spc6486/bookmac/pcb/keyboard-controller/keyboard-controller-partlist.txt

Partlist exported from Fusion Hub: Scott Chamberlain   Project: Macintosh Protoypes  Board: Keyboard Controller PCB 2D v28 at 9/15/25 21:02

Qty Value                             Device                            Package                 Parts              Description                         AVAILABILITY CATEGORY   CHECK_PRICES                                                                                  COMMENT                         DATASHEET                                      DESCRIPTION                                                                                                                                                                              EU_ROHS_COMPLIANCE                                                                                                                                 MANUFACTURER MF                           MP            MPN            OPERATING_TEMP                                                                         OPERATING_TEMPERATURE PACKAGE                    PACKAGE_SIZE    PACKAGE_TYPE                PART_STATUS PITCH           PRICE ROHS      ROHS_COMPLIANT SERIES SNAPEDA_LINK                                                              SUB-CATEGORY                                                                                   SUBCATEGORY                              TEMPERATURE_COEFFICIENT          THERMALLOSS TOLERANCE TYPE                                                                                       VOLTAGE_RATING
5   .1uF                              C_CHIP-0402(1005-METRIC)          CAPC1005X60             C5, C6, C7, C8, C9 Capacitor - Generic                              Capacitor                                                                                                                                                                                                                                                                                                                                                                                                                                                                                                                                                                                                                                                                                                                                          0402            Surface Mount                                                                                                                                                                                                                                                          Ceramic Capacitors                                                                              MLCC                                                                                                     
1   0466.500NRHF                      0466.500NRHF                      FUSC3115X66N            F1                 Check availability                  In Stock                https://www.snapeda.com/parts/0466.500NRHF/Littelfuse/view-part/?ref=eda                                                                                                                                                           470 Series 1206 Fast-Acting Fuse                                                                                                                                                                                                                                                                   Littelfuse Inc.              0466.500NRHF                                                                                                                              1206 Littelfuse Inc.                                                                               None                                  https://www.snapeda.com/parts/0466.500NRHF/Littelfuse/view-part/?ref=snap                                                                                                                                                                                                                                                                                                         
2   10k                               R_CHIP-0402(1005-METRIC)          RESC1005X40             R1, R3             Resistor Fixed - Generic                         Resistors                                                                                                                                                                               Chip Resistor 1.05 X 0.54 X 0.40 mm body 0402(1005-METRIC) Package                                                                                                                                                                                                                                                                                                                                                                                                                                                                                         0402            Surface Mount                                                                                                                                                                                                                                                                                                                                                                                                                                                                   
1   10uF                              C_CHIP-0402(1005-METRIC)          CAPC1005X60             C1                 Capacitor - Generic                              Capacitor                                                                                                                                                                                                                                                                                                                                                                                                                                                                                                                                                                                                                                                                                                                                          0402            Surface Mount                                                                                                                                                                                                                                                          Ceramic Capacitors                                                                              MLCC                                                                                                     
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
1   5499786-4_2.54-210PWEJECTORHEADER 5499786-4_2.54-210PWEJECTORHEADER TE_5499786-4            J2                 Check availability                  In Stock                https://www.snapeda.com/parts/5499786-4/TE+Connectivity+AMP+Connectors/view-part/?ref=eda     5499786-4                                                                                                                            HEADER                                                                                                                              UNIVERSAL EJECTION PIN                                                                                                                             AMP-LATCH    20 POS                       2.54 X 2.54   PCB            RIGHT ANGLE | TE Connectivity 5499786-4                                               Compliant                                        TE Connectivity 5499786-4                                                     None                                                                                                                                                                                                     None                                                                                            https://www.snapeda.com/parts/5499786-4/TE+Connectivity+AMP+Connectors/view-part/?ref=snap               
1   ATMEGA32U4-AU                     ATMEGA32U4-AU                     QFP80P1200X1200X120-44N U1                 Check availability                  In Stock                https://www.snapeda.com/parts/ATMEGA32U4-AU/Microchip/view-part/?ref=eda                                                                                                                                                           AVR AVR® ATmega Microcontroller IC 8-Bit 16MHz 32KB (16K x 16) FLASH 44-TQFP (10x10)                                                                                                                                                                                                               Microchip Technology / Atmel ATMEGA32U4-AU                                                                                                                             TQFP-44 Microchip                                                                                  None                                  https://www.snapeda.com/parts/ATMEGA32U4-AU/Microchip/view-part/?ref=snap                                                                                                                                                                                                                                                                                                         
1   FL1600087                         FL1600087                         XTAL_FL1600087          Y1                 Check availability                  In Stock                https://www.snapeda.com/parts/FL1600087/Diodes+Inc./view-part/?ref=eda                                                                                                                                                             Crystal 16MHz ±15ppm (Tol) ±15ppm (Stability) 20pF FUND 28.9Ohm 4-Pin SMD                                                                                                                                                                                                                          Diodes Incorporated          FL1600087                                                                                                                                 NON STANDARD-4 Diodes Inc.                                                                         None                                  https://www.snapeda.com/parts/FL1600087/Diodes+Inc./view-part/?ref=snap                                                                                                                                                                                                                                                                                                           
1   PINHD-2X3                         PINHD-2X3                         2X03                    JP1                Pin Header                                       Connectors                                                                                                                                                                              Header-Straight-2x3 Position                                                                                                                                                                                                                                                                                                                                                                                                                                                                                                                                               Through Hole                            0.100" (2.54mm)                                                                                                                                                                                                                Headers                                                                                         Male Pins                                                                                                
1   PRTR5V0U2X,215                    PRTR5V0U2X,215                    SOT143B                 D1                 Check availability                  In Stock                https://www.snapeda.com/parts/PRTR5V0U2X                                                      215/Nexperia/view-part/?ref=eda                                                                                                                                                                                                                                                                                               - Clamp - Ipp Tvs Diode Surface Mount SOT-143B                                                                                         Nexperia USA  PRTR5V0U2X     215                                                                                                                                                     SOT143B-4 Nexperia USA Inc.                                             None                                                                                                                                                                                           https://www.snapeda.com/parts/PRTR5V0U2X 215/Nexperia/view-part/?ref=snap                                                                                                                                
1   SPST-NO_SWITCH_KMR2               SPST-NO_SWITCH_KMR2               KMR2                    S1                 SPST Switches with NO Configuration              Switches                                                                                                                                 https://www.ckswitches.com/media/1479/kmr2.pdf Tactile Switch SPST-NO Top Actuated Surface Mount                                                                                                                                                                                                                                                                                           C&K                                                     KMR211G LFS                                                                                           -40°C ~ 85°C                                     NA              Surface Mount               Active                            Compliant                KMR2                                                                                                                                                                            Tactile Switches                                                                                SPST-NO                                                                                                  
1   TYPE-C-31-M-12                    TYPE-C-31-M-12                    HRO_TYPE-C-31-M-12      J1                 Check availability                  Not in stock            https://www.snapeda.com/parts/TYPE-C-31-M-12/HRO+Electronics+Co.%252C+Ltd./view-part/?ref=eda                                                                                                                                      USB Connectors 24 Receptacle 1 8.94*7.3mm RoHS                                                                                                                                                                                                                                                     HRO Electronics Co.           Ltd.         TYPE-C-31-M-12                                                                                                                                         Package                                                                       None                                                                                                      https://www.snapeda.com/parts/TYPE-C-31-M-12/HRO+Electronics+Co.%252C+Ltd./view-part/?ref=snap
