spc6486/bookmac/pcb/rear-port-av/rear-port-av-partlist.txt

Partlist exported from Fusion Hub: Scott Chamberlain   Project: Macintosh Protoypes  Board: Rear Port AV PCB 2D v21 at 9/16/25 18:32

Qty Value      Device     Package        Parts  Description                   AVAILABILITY CATEGORY   CHECK_PRICES                                                                              DATASHEET                                       DESCRIPTION                                                             MANUFACTURER           MF                                                             MP                                                                   MPN                                                                                    OPERATING_TEMPERATURE PACKAGE                        PACKAGE_SIZE PACKAGE_TYPE PART_STATUS PITCH            PRICE ROHS      SERIES SNAPEDA_LINK SUBCATEGORY             THERMALLOSS                                                        TYPE                                                                 
1   1658998-1  1658998-1  TE_1658998-1   J3     Check availability            In Stock                https://www.snapeda.com/parts/1658998-1/TE+Connectivity+AMP+Connectors/view-part/?ref=eda                                                                                                       Connector          Mini Circular DIN      Receptacle Assy w/ Hold Down                                   8 Pos.                                                               Right Angle | TE Connectivity 1658998-1                                                                     TE Connectivity AMP Connectors 1658998-1                             None                                                 None                                                                                                                                                            
1   B2B-XH-A   B2B-XH-A   B2B-XH-A       J1     XH Connector Top Entry - 2POS              Connectors                                                                                           https://www.jst-mfg.com/product/pdf/eng/eXH.pdf Connector Header Through Hole 2 position 0.098" (2.50mm)                JST Sales America Inc.                                                                                                                                     B2B-XH-A                                                                               -25°C ~ 85°C                                         NA           Through Hole Active      0.098" (2.50mm)        Compliant XH                  Rectangular Connectors                                                                     Male Headers                                                         
1   PINHD-2X4  PINHD-2X4  2X04           JP1    Pin Header                                 Connectors                                                                                                                                           Header-Straight-2x4 Position                                                                                                                                                                                                                                                                                                                                                                Through Hole             0.100" (2.54mm)                                      Headers                                                                                    Male Pins                                                            
1   RCJ-011    RCJ-011    CUI_RCJ-011    J7     Check availability            In Stock                https://www.snapeda.com/parts/RCJ-011/Same+Sky/view-part/?ref=eda                                                                                                                               Metal Right-Angle  RCA Jack               Black Insulator                                                                                                                    Same Sky                                                                               RCJ-011                                                           None                                                      None                                        https://www.snapeda.com/parts/RCJ-011/Same+Sky/view-part/?ref=snap                                                                      
2   SJ1-3533NS SJ1-3533NS CUI_SJ1-3533NS J4, J6 Check availability            In Stock                https://www.snapeda.com/parts/SJ1-3533NS/Same+Sky/view-part/?ref=eda                                                                                                                            3.50mm (0.141      1/8                    Mini Plug) - Headphone Phone Jack Stereo (3 Conductor          TRS) Connector Solder                                                                                                                                      Same Sky              SJ1-3533NS                                               None                                                None                                                                                                    https://www.snapeda.com/parts/SJ1-3533NS/Same+Sky/view-part/?ref=snap
