spc6486/bookmac/pcb/rear-port-power/rear-port-power-partlist.txt

Partlist exported from Fusion Hub: Scott Chamberlain   Project: Macintosh Protoypes  Board: Rear Port Pwr PCB 2D v36 at 9/16/25 21:17

Qty Value        Device       Package         Parts        Description                   AVAILABILITY CATEGORY   CHECK_PRICES                                                           DATASHEET                                       DESCRIPTION                                                                                                                                                                                               MANUFACTURER           MF       MP                    MPN      OPERATING_TEMPERATURE PACKAGE                                                                   PACKAGE_SIZE PACKAGE_TYPE PART_STATUS  PITCH            PRICE ROHS      SERIES SNAPEDA_LINK                                                      SUBCATEGORY             THERMALLOSS TYPE        
2   B2B-XH-A     B2B-XH-A     B2B-XH-A        POWER, RESET XH Connector Top Entry - 2POS              Connectors                                                                        https://www.jst-mfg.com/product/pdf/eng/eXH.pdf Connector Header Through Hole 2 position 0.098" (2.50mm)                                                                                                                                                  JST Sales America Inc.                                B2B-XH-A -25°C ~ 85°C                                                                                    NA           Through Hole Active       0.098" (2.50mm)        Compliant XH                                                                       Rectangular Connectors              Male Headers
1   SPPJ222200   SPPJ222200   SW_SPPJ222200   S1           Check availability            In Stock                https://www.snapeda.com/parts/SPPJ222200/ALPS/view-part/?ref=eda                                                                                                             Switch Push Button N.O./N.C. DPDT Plunger 0.2A 30VDC Latching PC Pins Bracket Mount/Through Hole Bulk                                                                      ALPS     SPPJ222200                                           None                                                                                                                              None                   https://www.snapeda.com/parts/SPPJ222200/ALPS/view-part/?ref=snap                                                 
1   TL1105RF160Q TL1105RF160Q SW_TL1105RF160Q S2           Check availability            In Stock                https://www.snapeda.com/parts/TL1105RF160Q/E-Switch/view-part/?ref=eda                                                                                                       Tactile Switch                                                                                                                                       TL1105 Series          SPST-NO  6.15mm Side Actuated  0.05A    12VDC                 PC | E-Switch TL1105RF160Q                                                            E-Switch     TL1105RF160Q                        None                                                                                                                   None
