spc6486/bookmac/pcb/keyboard/keyboard-bom.xlsx

Comment | Designator | Footprint | JLCPCB Part #（optional）
Diode | D1 | 1N4148W-7-F
Diode | D2 | 1N4148W-7-F
Diode | D3 | 1N4148W-7-F
Diode | D4 | 1N4148W-7-F
Diode | D5 | 1N4148W-7-F
Diode | D6 | 1N4148W-7-F
Diode | D7 | 1N4148W-7-F
Diode | D8 | 1N4148W-7-F
Diode | D9 | 1N4148W-7-F
Diode | D10 | 1N4148W-7-F
Diode | D11 | 1N4148W-7-F
Diode | D12 | 1N4148W-7-F
Diode | D13 | 1N4148W-7-F
Diode | D14 | 1N4148W-7-F
Diode | D15 | 1N4148W-7-F
Diode | D16 | 1N4148W-7-F
Diode | D17 | 1N4148W-7-F
Diode | D18 | 1N4148W-7-F
Diode | D19 | 1N4148W-7-F
Diode | D20 | 1N4148W-7-F
Diode | D21 | 1N4148W-7-F
Diode | D22 | 1N4148W-7-F
Diode | D23 | 1N4148W-7-F
Diode | D24 | 1N4148W-7-F
Diode | D25 | 1N4148W-7-F
Diode | D26 | 1N4148W-7-F
Diode | D27 | 1N4148W-7-F
Diode | D28 | 1N4148W-7-F
Diode | D29 | 1N4148W-7-F
Diode | D30 | 1N4148W-7-F
Diode | D31 | 1N4148W-7-F
Diode | D32 | 1N4148W-7-F
Diode | D33 | 1N4148W-7-F
Diode | D34 | 1N4148W-7-F
Diode | D35 | 1N4148W-7-F
Diode | D36 | 1N4148W-7-F
Diode | D37 | 1N4148W-7-F
Diode | D38 | 1N4148W-7-F
Diode | D39 | 1N4148W-7-F
Diode | D40 | 1N4148W-7-F
Diode | D41 | 1N4148W-7-F
Diode | D42 | 1N4148W-7-F
Diode | D43 | 1N4148W-7-F
Diode | D44 | 1N4148W-7-F
Diode | D45 | 1N4148W-7-F
Diode | D46 | 1N4148W-7-F
Diode | D47 | 1N4148W-7-F
Diode | D48 | 1N4148W-7-F
Diode | D49 | 1N4148W-7-F
Diode | D50 | 1N4148W-7-F
Diode | D51 | 1N4148W-7-F
Diode | D52 | 1N4148W-7-F
Diode | D53 | 1N4148W-7-F
Diode | D54 | 1N4148W-7-F
Diode | D55 | 1N4148W-7-F
Diode | D56 | 1N4148W-7-F
Diode | D57 | 1N4148W-7-F
Diode | D58 | 1N4148W-7-F
Cherry | U$1 | MX2B-L2NA
Cherry | U$2 | MX2B-L2NA
Cherry | U$3 | MX2B-L2NA
Cherry | U$4 | MX2B-L2NA
Cherry | U$5 | MX2B-L2NA
Cherry | U$6 | MX2B-L2NA
Cherry | U$7 | MX2B-L2NA
Cherry | U$8 | MX2B-L2NA
Cherry | U$9 | MX2B-L2NA
Cherry | U$10 | MX2B-L2NA
Cherry | U$11 | MX2B-L2NA
Cherry | U$12 | MX2B-L2NA
Cherry | U$13 | MX2B-L2NA
Cherry | U$14 | MX2B-L2NA
Cherry | U$15 | MX2B-L2NA
Cherry | U$16 | MX2B-L2NA
Cherry | U$17 | MX2B-L2NA
Cherry | U$18 | MX2B-L2NA
Cherry | U$19 | MX2B-L2NA
Cherry | U$20 | MX2B-L2NA
Cherry | U$21 | MX2B-L2NA
Cherry | U$22 | MX2B-L2NA
Cherry | U$23 | MX2B-L2NA
Cherry | U$24 | MX2B-L2NA
Cherry | U$25 | MX2B-L2NA
Cherry | U$26 | MX2B-L2NA
Cherry | U$27 | MX2B-L2NA
Cherry | U$28 | MX2B-L2NA
Cherry | U$29 | MX2B-L2NA
Cherry | U$30 | MX2B-L2NA
Cherry | U$31 | MX2B-L2NA
Cherry | U$32 | MX2B-L2NA
Cherry | U$33 | MX2B-L2NA
Cherry | U$34 | MX2B-L2NA
Cherry | U$35 | MX2B-L2NA
Cherry | U$36 | MX2B-L2NA
Cherry | U$37 | MX2B-L2NA
Cherry | U$38 | MX2B-L2NA
Cherry | U$39 | MX2B-L2NA
Cherry | U$40 | MX2B-L2NA
Cherry | U$41 | MX2B-L2NA
Cherry | U$42 | MX2B-L2NA
Cherry | U$43 | MX2B-L2NA
Cherry | U$44 | MX2B-L2NA
Cherry | U$45 | MX2B-L2NA
Cherry | U$46 | MX2B-L2NA
Cherry | U$47 | MX2B-L2NA
Cherry | U$48 | MX2B-L2NA
Cherry | U$49 | MX2B-L2NA
Cherry | U$50 | MX2B-L2NA
Cherry | U$51 | MX2B-L2NA
Cherry | U$52 | MX2B-L2NA
Cherry | U$53 | MX2B-L2NA
Cherry | U$54 | MX2B-L2NA
Cherry | U$55 | MX2B-L2NA
Cherry | U$56 | MX2B-L2NA
Cherry | U$57 | MX2B-L2NA
Cherry | U$58 | MX2B-L2NA
