spc6486/bookmac/pcb/rear-port-av/rear-port-av-bom.xlsx

Comment | Designator | Footprint | JLCPCB Part #（optional）
1658998-1 | J3 | 1658998-1
B2B-XH-A | J1 | B2B-XH-A
PINHD-2X4 | JP1 | PINHD-2X4
RCJ-011 | J7 | RCJ-011
SJ1-3533NS | J4, J6 | SJ1-3533NS
