spc6486/bookmac/pcb/rear-port-power/rear-port-power-bom.xlsx

Comment | Designator | Footprint | JLCPCB Part #（optional）
B2B-XH-A | POWER,RESET | B2B-XH-A
SPPJ222200 | S1 | SW_SPPJ222200
TL1105RF160Q | S2 | SW_TL1105RF160Q
