spc6486/bookmac/pcb/keyboard-controller/keyboard-controller-bom.xlsx

Comment | Designator | Footprint | JLCPCB Part #（optional）
.1uF | C5, C6, C7, C8, C9 | CAPC1005X60
0466.500NRHF | F1 | FUSC3115X66N
10k | R1, R3 | RESC1005X40
10uF | C1 | CAPC1005X60
1uF | C2 | CAPC1005X60
20pF | C3 | CAPC1005X60
20pf | C4 | CAPC1005X60
22 | R4, R5 | RESC1005X40
5.1k | R2, R7 | RESC1005X40
5499786-4_2.54-210PWEJECTORHEADER | J2 | ORHEADER TE_5499786-4
ATMEGA32U4-AU | U1 | QFP80P1200X1200X120-44N
FL1600087 | Y1 | XTAL_FL1600087
PINHD-2X3 | JP1 | 2X03
PRTR5V0U2X,215 | D1 | SOT143B
SPST-NO_SWITCH_KMR2 | S1 | KMR2
TYPE-C-31-M-12 | J1 | HRO_TYPE-C-31-M-12
