spc6486/bookmac/enclosure/bookmac/lower-body.stl

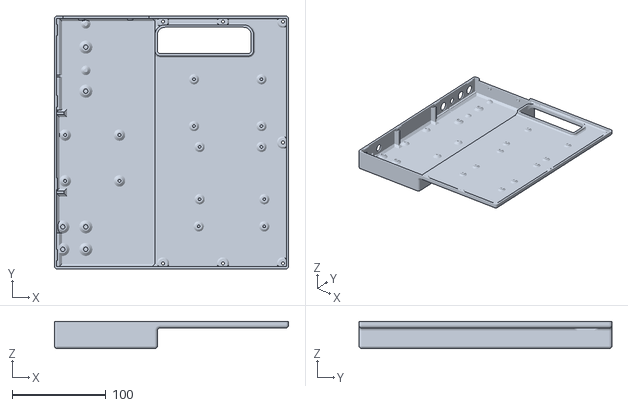
[picture p10: CAD file, 2026-10-26]
enclosure/bookmac/lower-body.stl
250.0 x 270.0 x 29.0
