spc6486/bookmac/enclosure/jigs/key-cap-decal-holder.stl

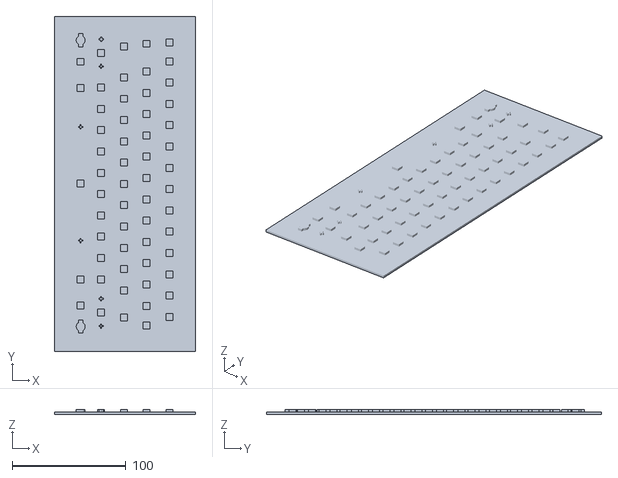
[picture p11: CAD file, 2026-10-26]
enclosure/jigs/key-cap-decal-holder.stl
124.1 x 295.1 x 4.00
