spc6486/bookmac/enclosure/bookmac/keyboard-bezel.stl

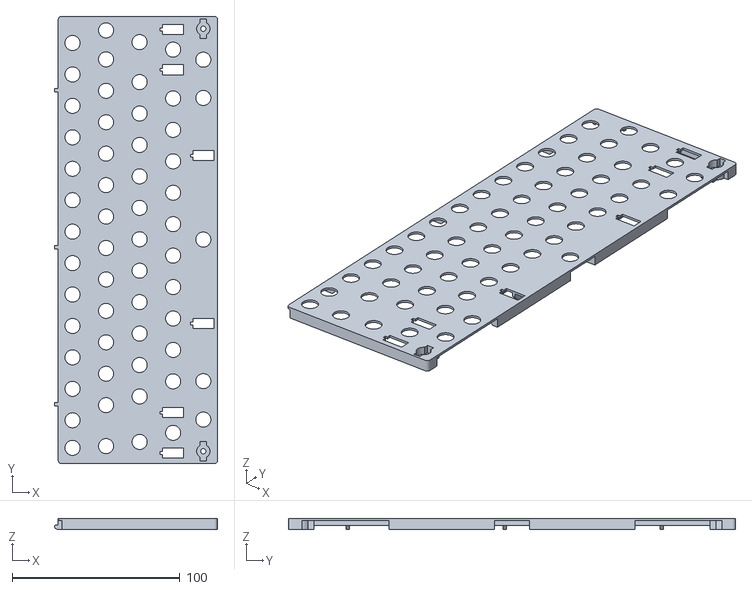
[picture p12: CAD file, 2026-10-26]
enclosure/bookmac/keyboard-bezel.stl
97.4 x 266.6 x 6.42
