spc6486/bookmac/enclosure/jigs/key-cap-holder.stl

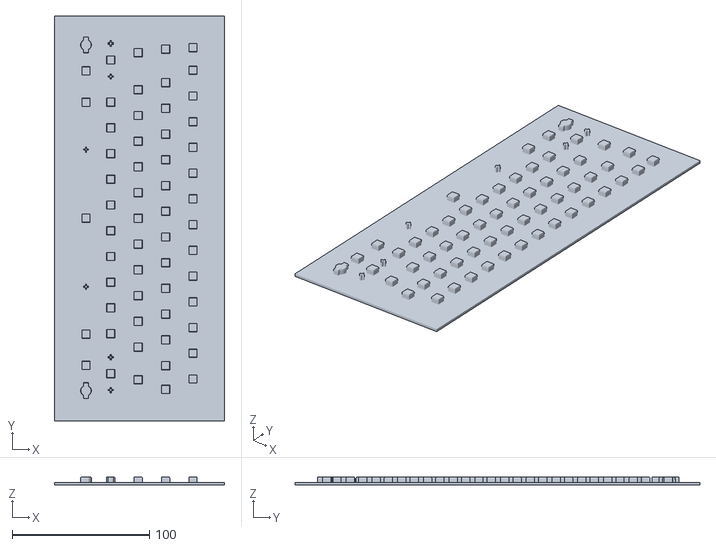
[picture p13: CAD file, 2026-10-26]
enclosure/jigs/key-cap-holder.stl
124.1 x 295.1 x 6.00
