spc6486/bookmac/enclosure/bookmac-mini/bookmac-mini.step

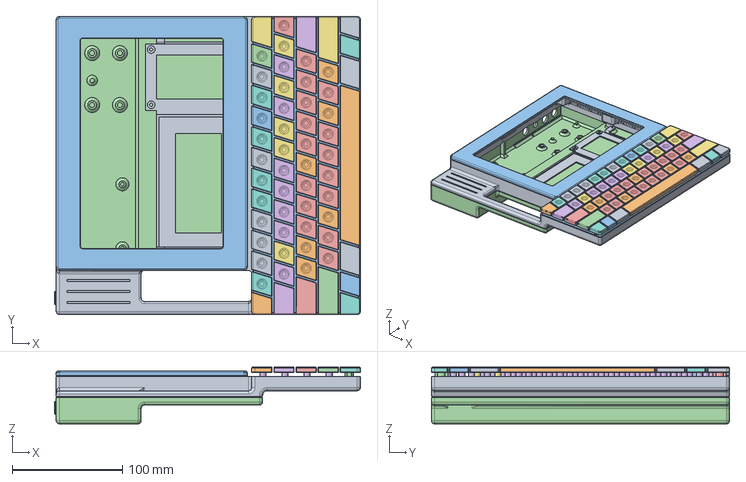
[picture p14: CAD file, 2026-10-25]
enclosure/bookmac-mini/bookmac-mini.step
277.0 x 270.0 x 51.5 mm
