spc6486/bookmac/enclosure/bookmac/floppy-slot-cover.stl

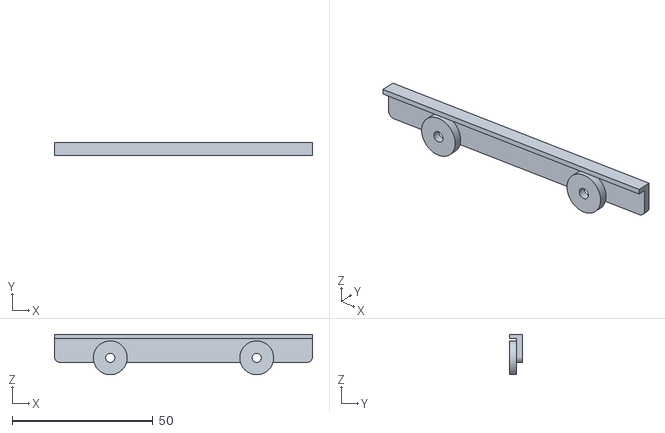
[picture p15: CAD file, 2026-10-26]
enclosure/bookmac/floppy-slot-cover.stl
91.6 x 4.50 x 14.4
