spc6486/bookmac/enclosure/bookmac/mid-body.stl

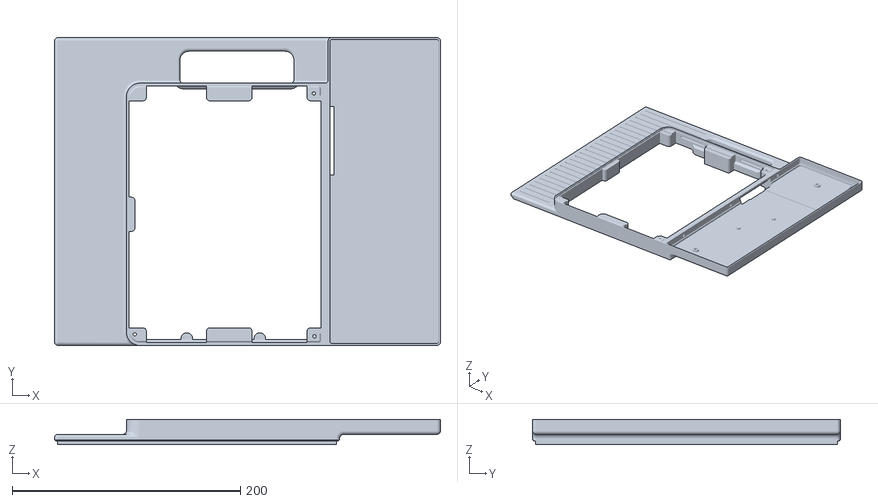
[picture p16: CAD file, 2026-10-26]
enclosure/bookmac/mid-body.stl
338.5 x 270.0 x 22.0
