spc6486/bookmac/enclosure/bookmac/key-caps.stl

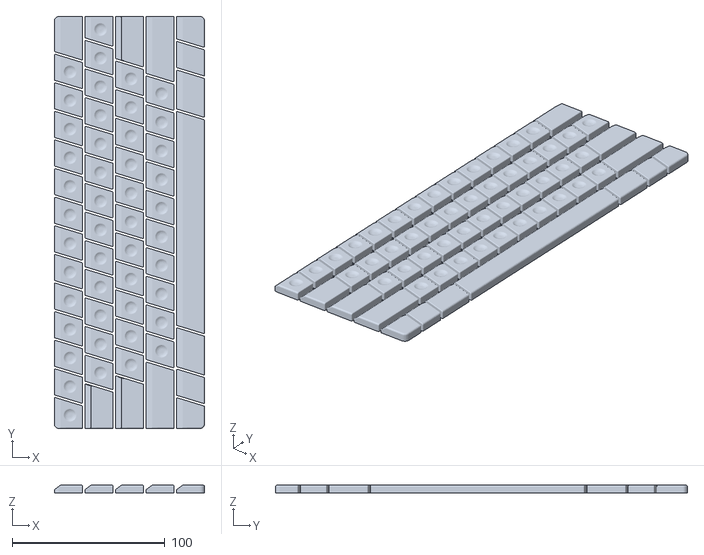
[picture p17: CAD file, 2026-10-26]
enclosure/bookmac/key-caps.stl
98.5 x 270.0 x 5.00
