spc6486/bookmac/enclosure/bookmac-mini/battery-tray.stl

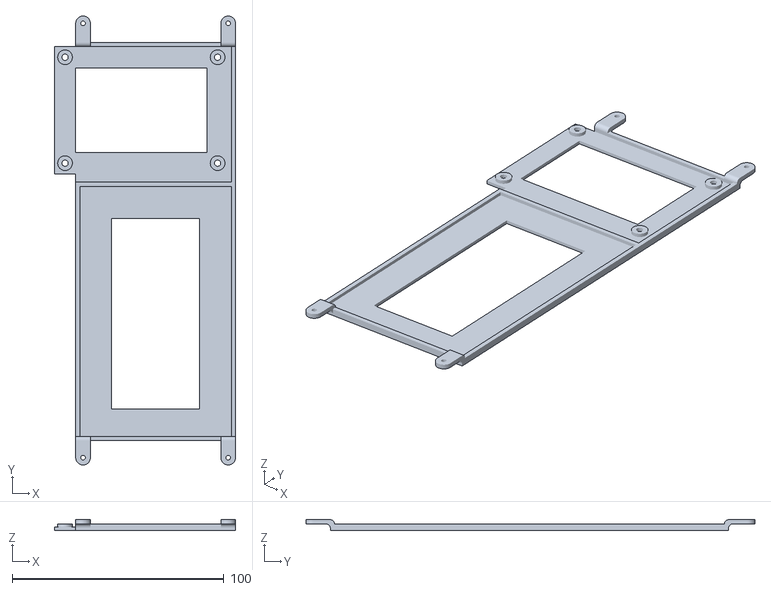
[picture p18: CAD file, 2026-10-25]
enclosure/bookmac-mini/battery-tray.stl
85.5 x 212.0 x 5.00
