spc6486/bookmac/enclosure/bookmac/power-button.stl

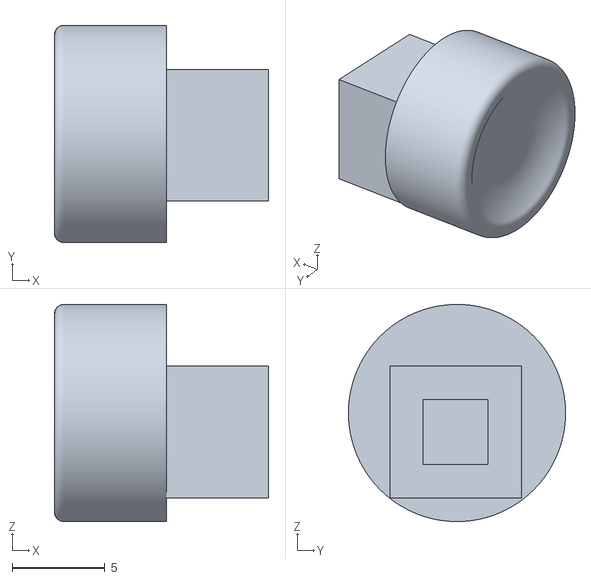
[picture p19: CAD file, 2026-10-26]
enclosure/bookmac/power-button.stl
11.5 x 11.7 x 11.7
