spc6486/bookmac/enclosure/bookmac/key-cap-stems.stl

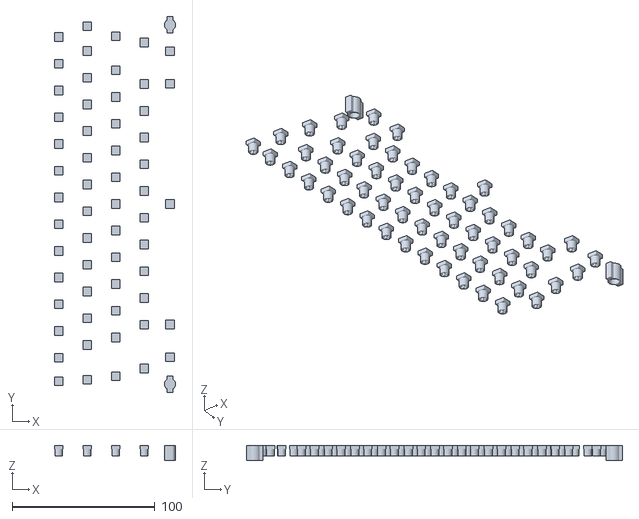
[picture p20: CAD file, 2026-10-26]
enclosure/bookmac/key-cap-stems.stl
85.0 x 263.7 x 10.3
