spc6486/bookmac/enclosure/bookmac-mini/dc-jack-holder.stl

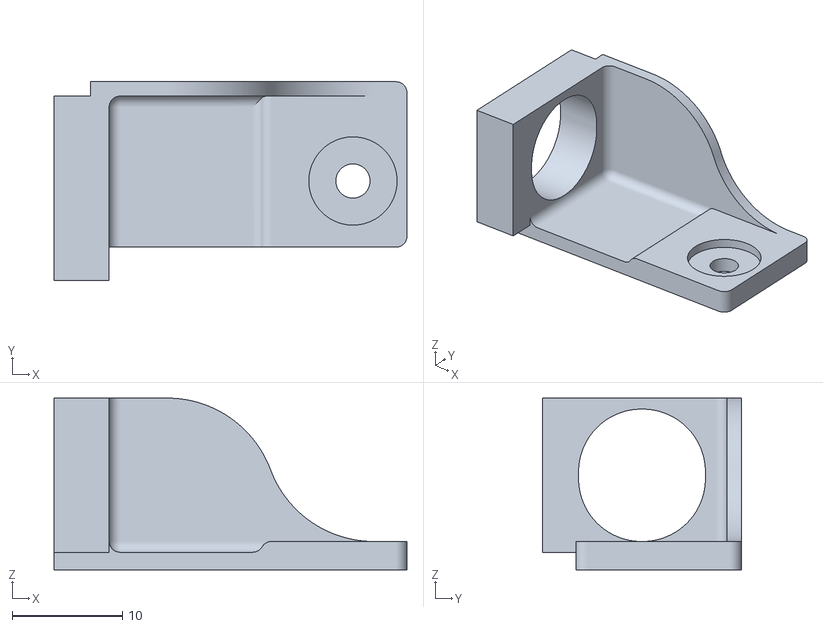
[picture p21: CAD file, 2026-10-25]
enclosure/bookmac-mini/dc-jack-holder.stl
32.0 x 18.0 x 15.6
