spc6486/bookmac/enclosure/bookmac/screen-bezel.stl

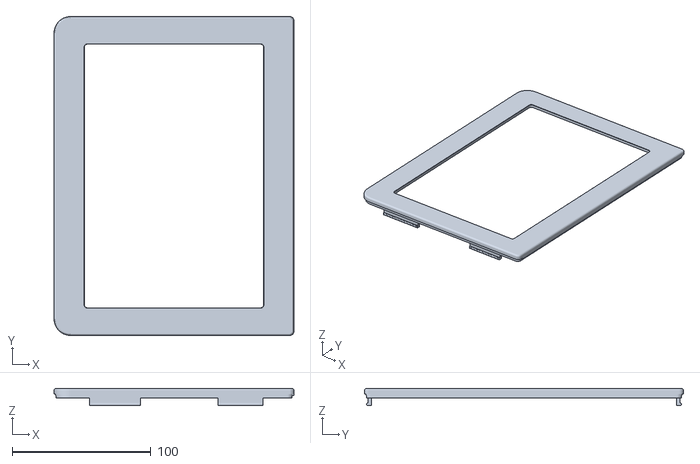
[picture p22: CAD file, 2026-10-26]
enclosure/bookmac/screen-bezel.stl
173.0 x 230.0 x 12.5
