spc6486/bookmac/enclosure/bookmac/bookmac.step

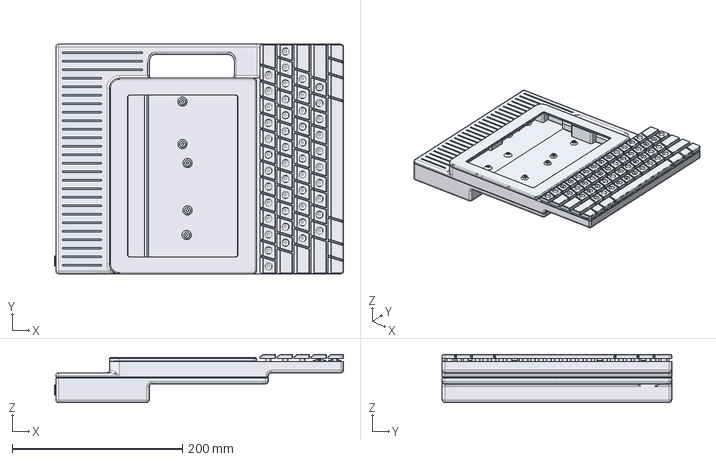
[picture p23: CAD file, 2026-10-25]
enclosure/bookmac/bookmac.step
340.0 x 270.0 x 56.5 mm
