spc6486/bookmac/enclosure/bookmac-mini/mid-body.stl

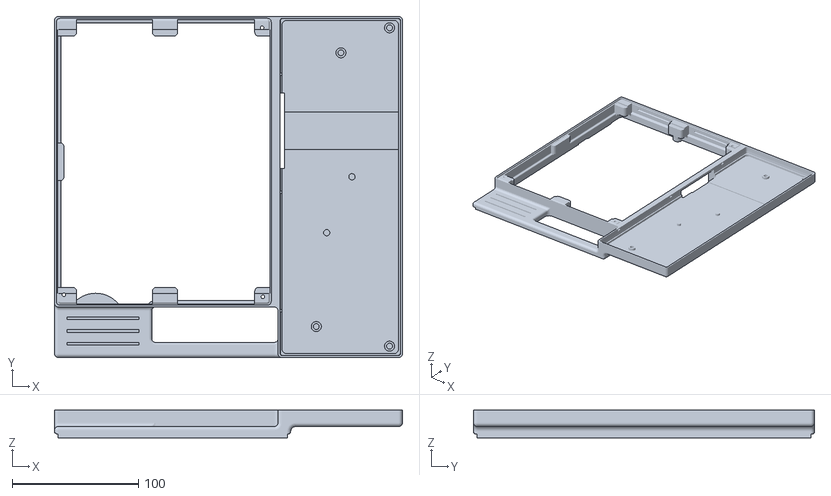
[picture p24: CAD file, 2026-10-25, an earlier design]
enclosure/bookmac-mini/mid-body.stl
275.5 x 270.0 x 22.0
