spc6486/bookmac/enclosure/bookmac-mini/keyboard-bezel.stl

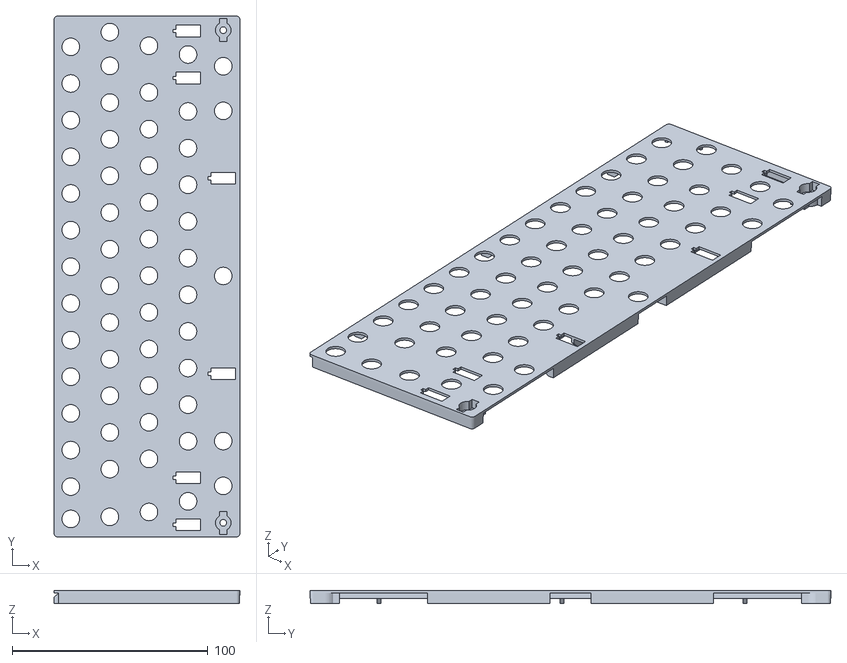
[picture p25: CAD file, 2026-10-25, an earlier design]
enclosure/bookmac-mini/keyboard-bezel.stl
95.0 x 266.5 x 6.42
