spc6486/bookmac/enclosure/bookmac-mini/screen-bezel.stl

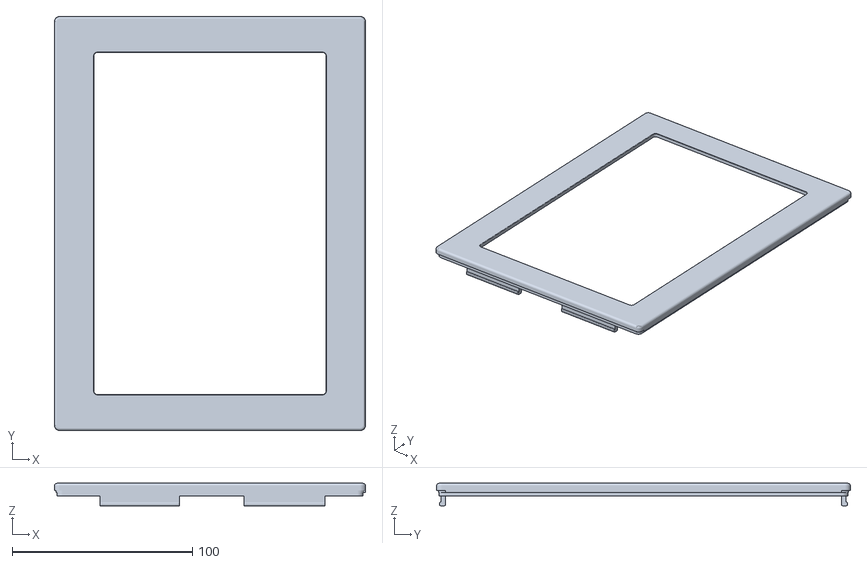
[picture p26: CAD file, 2026-10-25, an earlier design]
enclosure/bookmac-mini/screen-bezel.stl
173.0 x 230.0 x 12.5
