spc6486/bookmac/enclosure/bookmac-mini/lower-body.stl

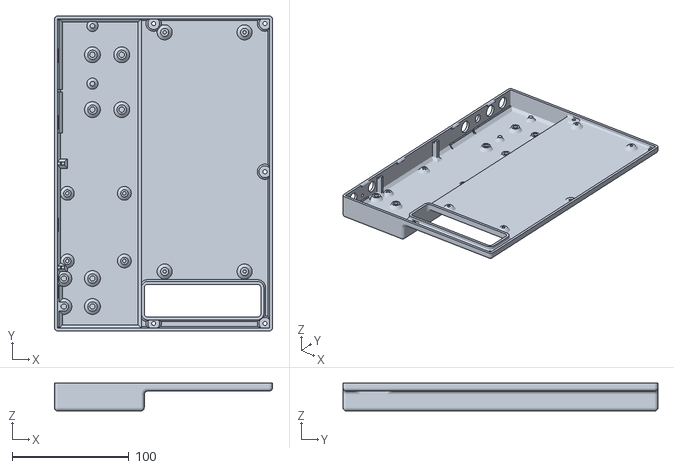
[picture p27: CAD file, 2026-10-25, an earlier design]
enclosure/bookmac-mini/lower-body.stl
187.0 x 270.0 x 24.0
