spc6486/bookmac/(list of files, cad)

Other CAD files:
enclosure/bookmac-mini/key-caps.stl
enclosure/bookmac-mini/power-button.stl
