spc6486/bookmac/decals/bookmac-keycaps.pdf

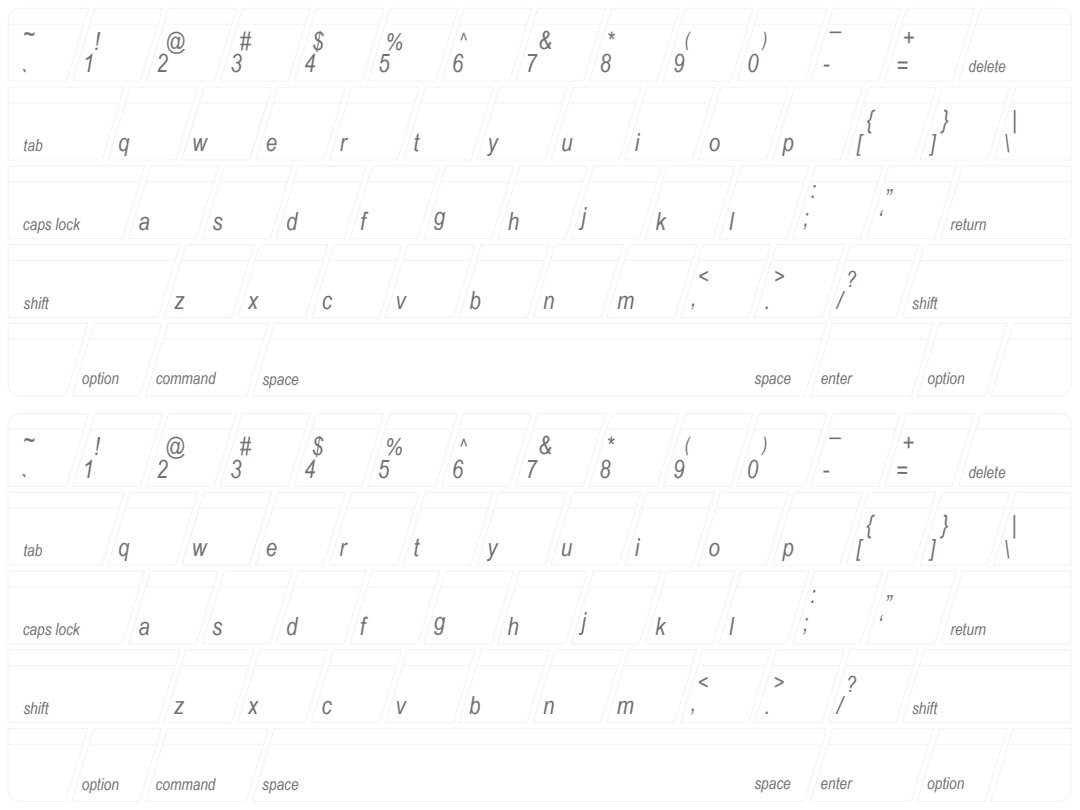
[picture p31: page 1]
delete; tab; return; shift; caps lock; option; command; space; enter
