spc6486/bookmac/decals/bookmac-mini-keycaps.pdf

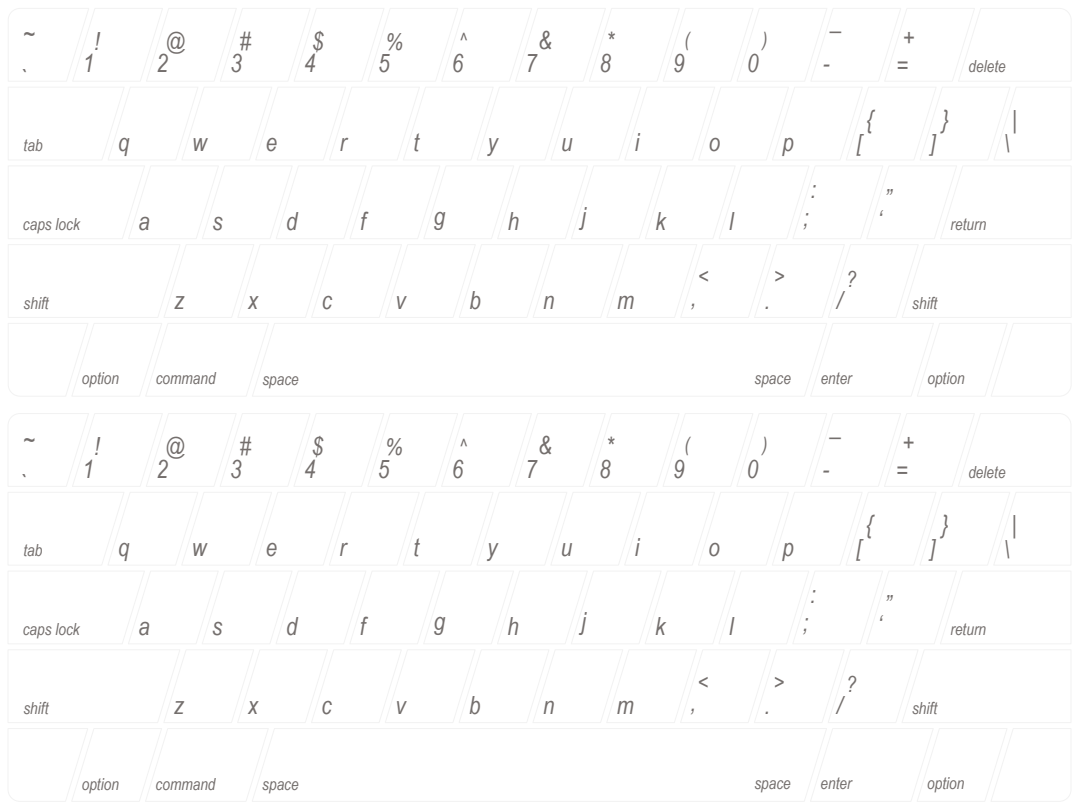
[picture p32: page 1]
delete; tab; return; shift; caps lock; option; command; space; enter
