spc6486/bookmac/pcb/keyboard-controller/keyboard-controller.brd

## EAGLE design pcb/keyboard-controller/keyboard-controller.brd (2026-10-25)

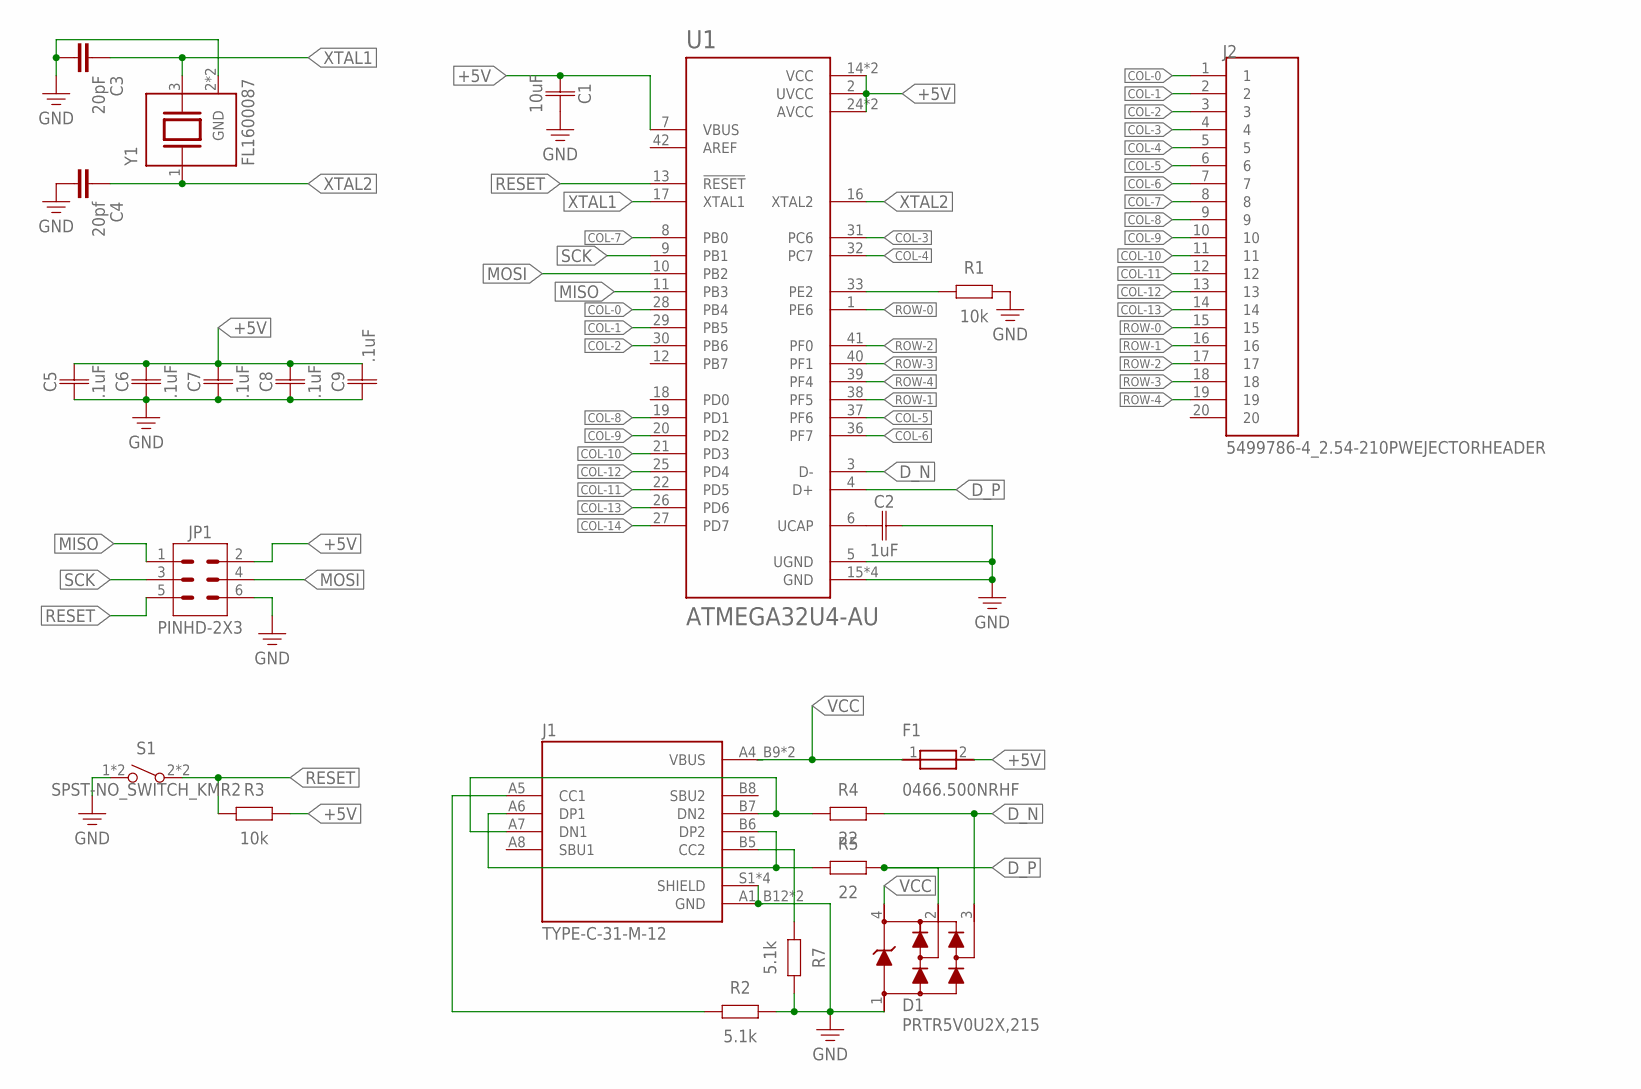
[picture p33: schematic keyboard-controller.sch]

Parts:
C1: 10uF; CAPC1005X60
C2: 1uF; CAPC1005X60
C3: 20pF; CAPC1005X60
C4: 20pf; CAPC1005X60
C5, C6, C7, C8, C9: .1uF; CAPC1005X60
D1: PRTR5V0U2X,215; SOT143B
F1: 0466.500NRHF; FUSC3115X66N
J1: TYPE-C-31-M-12; HRO_TYPE-C-31-M-12
J2: 5499786-4_2.54-210PWEJECTORHEADER; TE_5499786-4
JP1: PINHD-2X3; 2X03
R1, R3: 10k; RESC1005X40
R2, R7: 5.1k; RESC1005X40
R4, R5: 22; RESC1005X40
S1: SPST-NO_SWITCH_KMR2; KMR2
U1: ATMEGA32U4-AU; QFP80P1200X1200X120-44N
Y1: FL1600087; XTAL_FL1600087

Connections:
+5V: C1.1, C5.2, C6.2, C7.2, C8.2, C9.2, F1.2, JP1.2, R3.2, U1.2 (UVCC), U1.7 (VBUS), U1.14 (VCC), U1.24 (AVCC), U1.34 (VCC), U1.44 (AVCC)
CC1: J1.A5 (CC1), R2.1
CC2: J1.B5 (CC2), R7.1
COL-0: J2.1, U1.28 (PB4)
COL-1: J2.2, U1.29 (PB5)
COL-2: J2.3, U1.30 (PB6)
COL-3: J2.4, U1.31 (PC6)
COL-4: J2.5, U1.32 (PC7)
COL-5: J2.6, U1.37 (PF6)
COL-6: J2.7, U1.36 (PF7)
COL-7: J2.8, U1.8 (PB0)
COL-8: J2.9, U1.19 (PD1)
COL-9: J2.10, U1.20 (PD2)
COL-10: J2.11, U1.21 (PD3)
COL-11: J2.12, U1.22 (PD5)
COL-12: J2.13, U1.25 (PD4)
COL-13: J2.14, U1.26 (PD6)
COL-14: U1.27 (PD7)
D_N: D1.3, R4.2, U1.3 (D-)
D_P: D1.2, R5.2, U1.4 (D+)
GND: C1.2, C2.2, C3.2, C4.2, C5.1, C6.1, C7.1, C8.1, C9.1, D1.1, J1.A1_B12 (GND), J1.B1_A12 (GND), J1.S1 (SHIELD), J1.S2 (SHIELD), J1.S3 (SHIELD), J1.S4 (SHIELD), JP1.6, R1.2, R2.2, R7.2, S1.1, S1.4 (1), U1.5 (UGND), U1.15 (GND), U1.23 (GND), U1.35 (GND), U1.43 (GND), Y1.2 (GND), Y1.4 (GND)
MISO: JP1.1, U1.11 (PB3)
MOSI: JP1.4, U1.10 (PB2)
unnamed: R1.1, U1.33 (PE2)
unnamed: C2.1, U1.6 (UCAP)
unnamed: J1.A6 (DP1), J1.B6 (DP2), R5.1
unnamed: J1.A7 (DN1), J1.B7 (DN2), R4.1
RESET: JP1.5, R3.1, S1.2, S1.3 (2), U1.13 (!RESET)
ROW-0: J2.15, U1.1 (PE6)
ROW-1: J2.16, U1.38 (PF5)
ROW-2: J2.17, U1.41 (PF0)
ROW-3: J2.18, U1.40 (PF1)
ROW-4: J2.19, U1.39 (PF4)
SCK: JP1.3, U1.9 (PB1)
VCC: D1.4, F1.1, J1.A4_B9 (VBUS), J1.B4_A9 (VBUS)
XTAL1: C3.1, U1.17 (XTAL1), Y1.3 (2)
XTAL2: C4.1, U1.16 (XTAL2), Y1.1

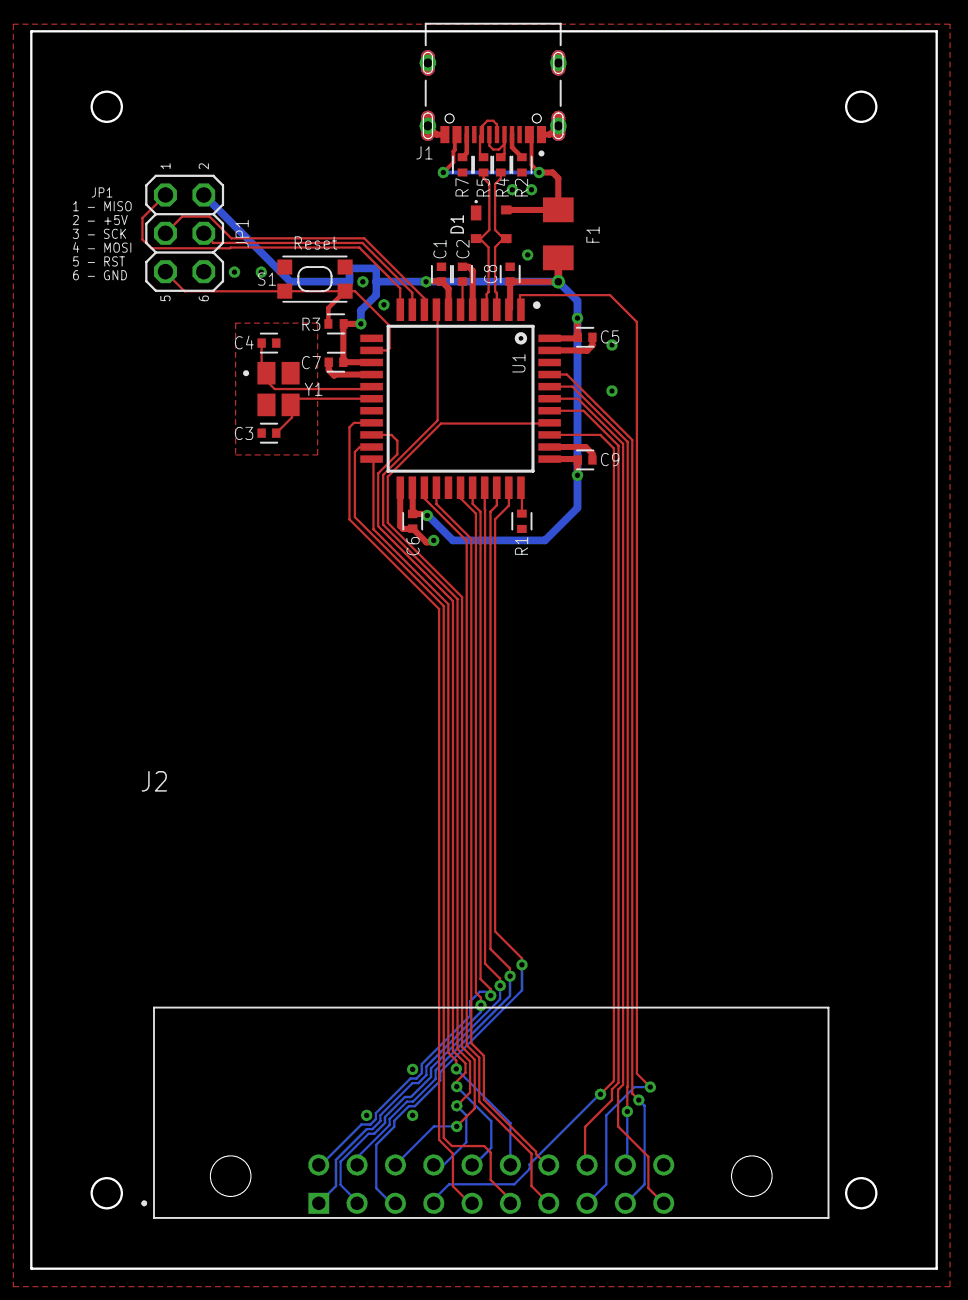
[picture p34: board keyboard-controller.brd from above]

Board: 2 copper layers, 60.0 x 82.0 mm, 23 parts (0 on the bottom side), 36 nets.
