spc6486/bookmac/pcb/keyboard/keyboard.brd

## EAGLE design pcb/keyboard/keyboard.brd (2026-10-25)

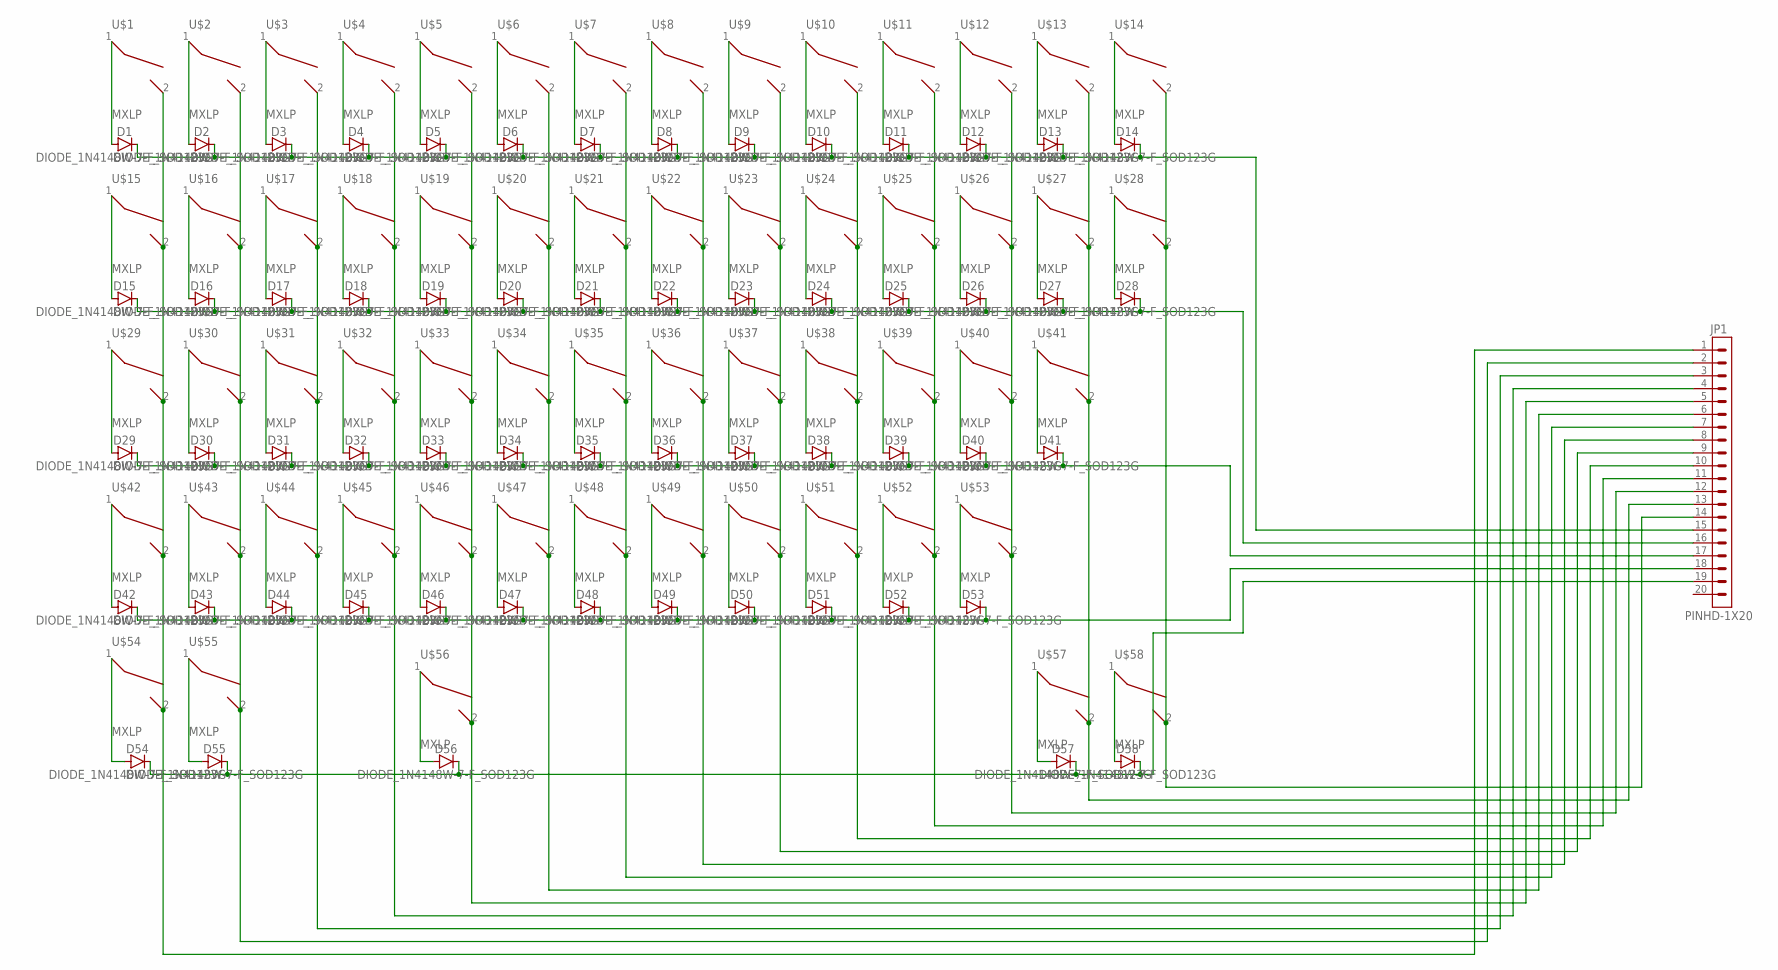
[picture p35: schematic keyboard.sch]

Parts:
D1, D2, D3, D4, D5, D6, D7, D8, D9, D10, D11, D12, D13, D14, D15, D16, D17, D18, D19, D20, D21, D22, D23, D24, D25, D26, D27, D28, D29, D30, D31, D32, D33, D34, D35, D36, D37, D38, D39, D40, D41, D42, D43, D44, D45, D46, D47, D48, D49, D50, D51, D52, D53, D54, D55, D56, D57, D58: DIODE_1N4148W-7-F_SOD123G; SOD3715X135
JP1: PINHD-1X20; 1X20
U$1, U$2, U$3, U$4, U$5, U$6, U$7, U$8, U$9, U$10, U$11, U$12, U$13, U$14, U$15, U$16, U$17, U$18, U$19, U$20, U$21, U$22, U$23, U$24, U$25, U$26, U$27, U$28, U$29, U$30, U$31, U$32, U$33, U$34, U$35, U$36, U$37, U$38, U$39, U$40, U$41, U$42, U$43, U$44, U$45, U$46, U$47, U$48, U$49, U$50, U$51, U$52, U$53, U$54, U$55, U$56, U$57, U$58: MXLP; CHERRY-MX-LOW-PROFILE

Connections:
unnamed: D1.2 (A), U$1.1
unnamed: D2.2 (A), U$2.1
unnamed: JP1.3, U$3.2, U$17.2, U$31.2, U$44.2
unnamed: D3.2 (A), U$3.1
unnamed: D4.2 (A), U$4.1
unnamed: D5.2 (A), U$5.1
unnamed: D6.2 (A), U$6.1
unnamed: D7.2 (A), U$7.1
unnamed: D8.2 (A), U$8.1
unnamed: D9.2 (A), U$9.1
unnamed: D10.2 (A), U$10.1
unnamed: D11.2 (A), U$11.1
unnamed: D12.2 (A), U$12.1
unnamed: D13.2 (A), U$13.1
unnamed: D14.2 (A), U$14.1
unnamed: D15.2 (A), U$15.1
unnamed: D16.2 (A), U$16.1
unnamed: D17.2 (A), U$17.1
unnamed: D18.2 (A), U$18.1
unnamed: D19.2 (A), U$19.1
unnamed: D20.2 (A), U$20.1
unnamed: D21.2 (A), U$21.1
unnamed: D22.2 (A), U$22.1
unnamed: D23.2 (A), U$23.1
unnamed: D24.2 (A), U$24.1
unnamed: D25.2 (A), U$25.1
unnamed: D26.2 (A), U$26.1
unnamed: D27.2 (A), U$27.1
unnamed: D28.2 (A), U$28.1
unnamed: D15.1 (C), D16.1 (C), D17.1 (C), D18.1 (C), D19.1 (C), D20.1 (C), D21.1 (C), D22.1 (C), D23.1 (C), D24.1 (C), D25.1 (C), D26.1 (C), D27.1 (C), D28.1 (C), JP1.16
unnamed: D29.2 (A), U$29.1
unnamed: D30.2 (A), U$30.1
unnamed: D31.2 (A), U$31.1
unnamed: D32.2 (A), U$32.1
unnamed: D33.2 (A), U$33.1
unnamed: D34.2 (A), U$34.1
unnamed: D35.2 (A), U$35.1
unnamed: D36.2 (A), U$36.1
unnamed: D37.2 (A), U$37.1
unnamed: D38.2 (A), U$38.1
unnamed: D39.2 (A), U$39.1
unnamed: D40.2 (A), U$40.1
unnamed: D41.2 (A), U$41.1
unnamed: D29.1 (C), D30.1 (C), D31.1 (C), D32.1 (C), D33.1 (C), D34.1 (C), D35.1 (C), D36.1 (C), D37.1 (C), D38.1 (C), D39.1 (C), D40.1 (C), D41.1 (C), JP1.17
unnamed: D42.2 (A), U$42.1
unnamed: D43.2 (A), U$43.1
unnamed: D44.2 (A), U$44.1
unnamed: D45.2 (A), U$45.1
unnamed: D46.2 (A), U$46.1
unnamed: D47.2 (A), U$47.1
unnamed: D48.2 (A), U$48.1
unnamed: D49.2 (A), U$49.1
unnamed: D50.2 (A), U$50.1
unnamed: D51.2 (A), U$51.1
unnamed: D52.2 (A), U$52.1
unnamed: D53.2 (A), U$53.1
unnamed: D42.1 (C), D43.1 (C), D44.1 (C), D45.1 (C), D46.1 (C), D47.1 (C), D48.1 (C), D49.1 (C), D50.1 (C), D51.1 (C), D52.1 (C), D53.1 (C), JP1.18
unnamed: D54.2 (A), U$54.1
unnamed: D55.2 (A), U$55.1
unnamed: D56.2 (A), U$56.1
unnamed: D57.2 (A), U$57.1
unnamed: D58.2 (A), U$58.1
unnamed: D54.1 (C), D55.1 (C), D56.1 (C), D57.1 (C), D58.1 (C), JP1.19
unnamed: JP1.1, U$1.2, U$15.2, U$29.2, U$42.2, U$54.2
unnamed: JP1.2, U$2.2, U$16.2, U$30.2, U$43.2, U$55.2
unnamed: JP1.4, U$4.2, U$18.2, U$32.2, U$45.2
unnamed: JP1.5, U$5.2, U$19.2, U$33.2, U$46.2, U$56.2
unnamed: JP1.6, U$6.2, U$20.2, U$34.2, U$47.2
unnamed: JP1.7, U$7.2, U$21.2, U$35.2, U$48.2
unnamed: JP1.8, U$8.2, U$22.2, U$36.2, U$49.2
unnamed: JP1.9, U$9.2, U$23.2, U$37.2, U$50.2
unnamed: JP1.10, U$10.2, U$24.2, U$38.2, U$51.2
unnamed: JP1.11, U$11.2, U$25.2, U$39.2, U$52.2
unnamed: JP1.12, U$12.2, U$26.2, U$40.2, U$53.2
unnamed: JP1.13, U$13.2, U$27.2, U$41.2, U$57.2
unnamed: JP1.14, U$14.2, U$28.2, U$58.2
ROW1: D1.1 (C), D2.1 (C), D3.1 (C), D4.1 (C), D5.1 (C), D6.1 (C), D7.1 (C), D8.1 (C), D9.1 (C), D10.1 (C), D11.1 (C), D12.1 (C), D13.1 (C), D14.1 (C), JP1.15

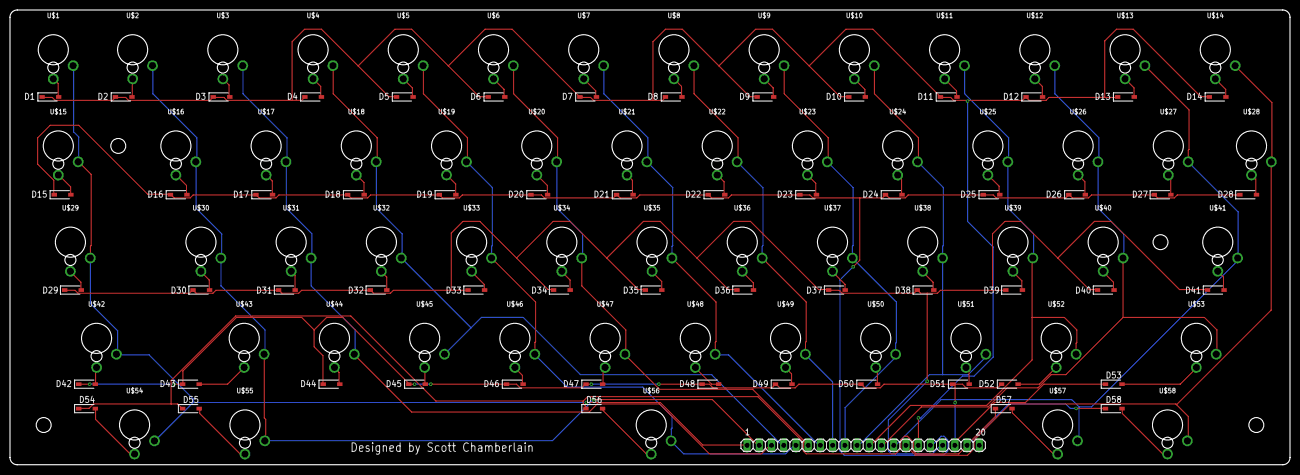
[picture p36: board keyboard.brd from above]

Board: 2 copper layers, 266.0 x 94.5 mm, 117 parts (0 on the bottom side), 77 nets.
