spc6486/bookmac/pcb/rear-port-power/rear-port-power.brd

## EAGLE design pcb/rear-port-power/rear-port-power.brd (2026-10-25)

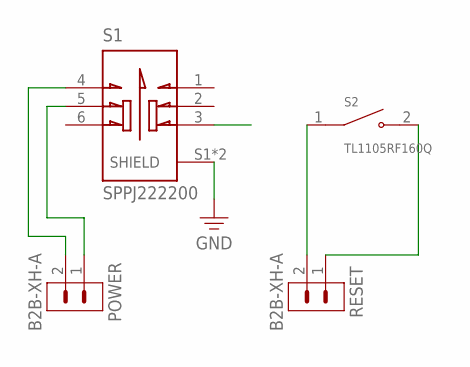
[picture p37: schematic rear-port-power.sch]

Parts:
POWER: B2B-XH-A
RESET: B2B-XH-A
S1: SPPJ222200; SW_SPPJ222200
S2: TL1105RF160Q; SW_TL1105RF160Q

Connections:
GND: S1.S1 (SHIELD), S1.S2 (SHIELD)
unnamed: POWER.2, S1.4
unnamed: POWER.1, S1.5
unnamed: RESET.2, S2.1
unnamed: RESET.1, S2.2

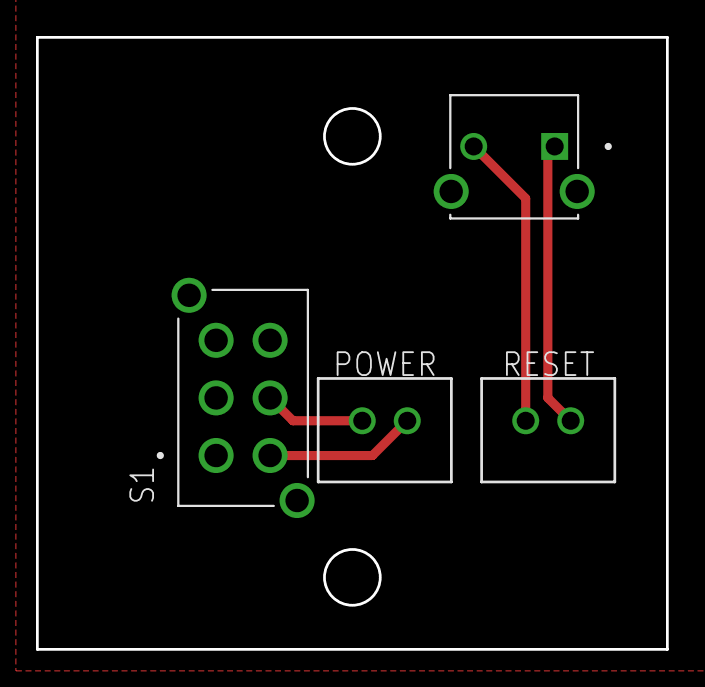
[picture p38: board rear-port-power.brd from above]

Board: 2 copper layers, 35.0 x 34.0 mm, 4 parts (0 on the bottom side), 5 nets.
