spc6486/bookmac/pcb/rear-port-av/rear-port-av.brd

## EAGLE design pcb/rear-port-av/rear-port-av.brd (2026-10-25)

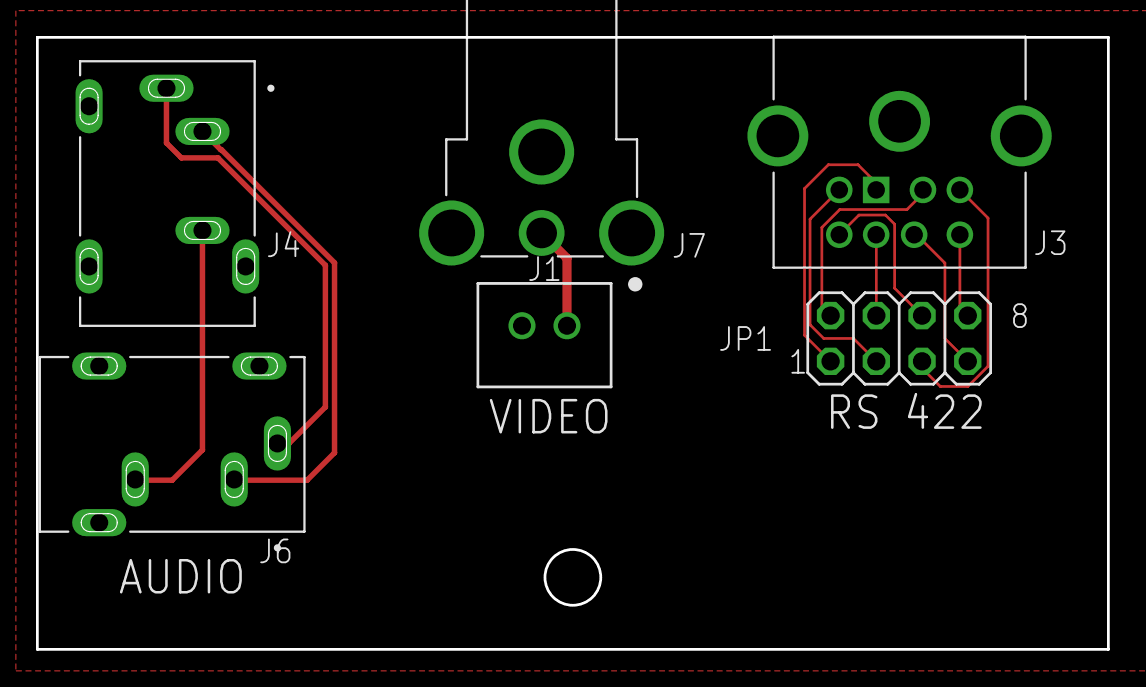
[picture p39: board rear-port-av.brd from above]

Board: 2 copper layers, 59.5 x 34.0 mm, 6 parts (0 on the bottom side), 13 nets.

Parts:
J1: B2B-XH-A
J3: 1658998-1; TE_1658998-1
J4, J6: SJ1-3533NS; CUI_SJ1-3533NS
J7: RCJ-011; CUI_RCJ-011
JP1: PINHD-2X4; 2X04

Connections:
D1: J3.1, JP1.1
D2: J3.2, JP1.2
D3: J3.3, JP1.3
D4: J3.4, JP1.4
D5: J3.5, JP1.5
D6: J3.6, JP1.6
D7: J3.7, JP1.7
D8: J3.8, JP1.8
GND: J1.1, J3.S1, J3.S2, J3.S3, J4.SH1, J4.SH2, J4.SH3, J6.SH1, J6.SH2, J6.SH3, J7.1A, J7.1B, J7.1C
unnamed: J4.1, J6.1
unnamed: J1.2, J7.2
unnamed: J4.3, J6.3
unnamed: J4.2, J6.2
