spc6486/bookmac/(commit log)

2026-10-25 Initial import: PCBs, enclosure, decals, firmware and docs
    Claude-Session: https://claude.ai/code/session_01N14yeRfJnfPKT37iydoLjj
    [battery-tray.stl, bookmac-mini.step, bookmac.step, dc-jack-holder.stl, key-caps.stl, keyboard-bezel.stl, keyboard-bom.xlsx, keyboard-controller-bom.xlsx]
2026-10-26 Switch hardware licence to CC BY-NC-SA 4.0; add CONTRIBUTING, PR template, at-cost permission; full-size STLs, images, paint article numbers
    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
2026-10-26 Add full-size STLs, keycap jigs and reference images (referenced by README)
    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
    [floppy-slot-cover.stl, key-cap-decal-holder.stl, key-cap-holder.stl, key-cap-stems.stl, key-caps.stl, keyboard-bezel.stl, lower-body.stl, mid-body.stl]
2026-10-26 Docs: display controller modifications, ribbon pin-1 and battery balancing notes, current layout photo; remove legacy UPS references
    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
2026-10-26 Add Mini renders; floppy slot note; ASA; base coat can number; observed battery capacity; Sponsor link
    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
2026-10-26 Link Mini Thingiverse listing; note JST XH 2-pin housings on the Pi GPIO header
    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
2026-10-26 Docs: PiPower 5 to Pi 5 connections, Pi J2 power button, display USB power from HAT header
    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
2026-10-26 Docs: female USB-C display power connector; full-size vs Mini header attachment
    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
2026-10-26 Docs: note soldered J2 and J7 pad connections
    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
